ivan-gluscic101/STM32-ESP32-Microphone-Array-Sound-Localization/Sound Localization/Core/Src/main.c

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
/* Includes ------------------------------------------------------------------*/
#include "main.h"
#include "cmsis_os.h"

/* USER CODE BEGIN Includes */
#include "adc_driver.h"      /* Custom_ACQ_Start */
#include "task_manager.h"    /* app_tasks_init */
#include "app_init.h"        /* app_init (I2C + IMU + dijagnostika) */
/* USER CODE END Includes */


COM_InitTypeDef BspCOMInit;

/* USER CODE BEGIN PV */
/* RTOS taskovi i queue-ovi kreiraju se u task_manager.c (app_tasks_init).
 * I2C se inicijalizira LL driverom (i2c_driver.c), ne HAL handle-om. */
/* USER CODE END PV */

void SystemClock_Config(void);
static void MX_GPIO_Init(void);
static void MX_DMA_Init(void);
static void MX_ADC1_Init(void);
static void MX_UART4_Init(void);
static void MX_TIM8_Init(void);

/* USER CODE BEGIN PFP */
/* I2C1 inicijalizira LL driver (Custom_I2C1_Init iz i2c_driver.c), ne CubeMX —
 * zato ovdje nema MX_I2C1_Init. Taskovi (Start*Task) su u task_manager.c. */

/* USER CODE END PFP */

/**
  * @brief  The application entry point.
  * @retval int
  */
int main(void)
{

  /* MCU Configuration--------------------------------------------------------*/

  /* Reset of all peripherals, Initializes the Flash interface and the Systick. */
  HAL_Init();

  /* Configure the system clock */
  SystemClock_Config();

  /* Initialize all configured peripherals */
  MX_GPIO_Init();
  MX_DMA_Init();
  MX_ADC1_Init();
  MX_UART4_Init();
  MX_TIM8_Init();
  /* USER CODE BEGIN 2 */
  /* Aplikacijski init (I2C LL + IMU + dijagnostika + kalibracija žira). Lokalizacija
   * (time-domain, LOC_INIT) i RTOS objekti su u task_manageru (app_tasks_init). */
  app_init();
  /* USER CODE END 2 */

  /* USER CODE BEGIN RTOS_MUTEX */
  /* add mutexes, ... */
  /* USER CODE END RTOS_MUTEX */

  /* USER CODE BEGIN RTOS_SEMAPHORES */
  /* add semaphores, ... */
  /* USER CODE END RTOS_SEMAPHORES */

  /* USER CODE BEGIN RTOS_TIMERS */
  /* start timers, add new ones, ... */
  /* USER CODE END RTOS_TIMERS */

  /* USER CODE BEGIN RTOS_THREADS */
  /* Svi queue-ovi i taskovi (ACQ/LOC/UART/IMU) kreiraju se u task_manager.c.
   * Kreiraj RTOS objekte (queueDmaEventHandle i dr.) PRIJE pokretanja ADC/DMA/TIM:
   * DMA1_Channel1_IRQHandler šalje u queueDmaEventHandle, koji nastaje ovdje.
   * Da ISR ne gađa NULL handle, Custom_ACQ_Start() ide tek nakon ovoga. */
  app_tasks_init();
  Custom_ACQ_Start();
  /* USER CODE END RTOS_THREADS */

  /* Initialize led */
  BSP_LED_Init(LED_GREEN);

  /* Initialize USER push-button, will be used to trigger an interrupt each time it's pressed.*/
  BSP_PB_Init(BUTTON_USER, BUTTON_MODE_EXTI);

  /* Initialize COM1 port (115200, 8 bits (7-bit data + 1 stop bit), no parity */
  BspCOMInit.BaudRate   = 115200;
  BspCOMInit.WordLength = COM_WORDLENGTH_8B;
  BspCOMInit.StopBits   = COM_STOPBITS_1;
  BspCOMInit.Parity     = COM_PARITY_NONE;
  BspCOMInit.HwFlowCtl  = COM_HWCONTROL_NONE;
  if (BSP_COM_Init(COM1, &BspCOMInit) != BSP_ERROR_NONE)
  {
    Error_Handler();
  }

  /* Start scheduler */
  osKernelStart();

  /* We should never get here as control is now taken by the scheduler */

  /* Infinite loop */
  /* USER CODE BEGIN WHILE */
  while (1)
  {

    /* USER CODE END WHILE */

    /* USER CODE BEGIN 3 */
  }
  /* USER CODE END 3 */
}

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
/* USER CODE BEGIN 4 */
/* HAL_TIM_PeriodElapsedCallback (TIM6 → HAL_IncTick) generira CubeMX niže. */

void vApplicationStackOverflowHook(TaskHandle_t xTask, char *pcTaskName)
{
  (void)xTask; (void)pcTaskName;
  __disable_irq();
  while (1) {}
}

void vApplicationMallocFailedHook(void)
{
  __disable_irq();
  while (1) {}
}
/* USER CODE END 4 */

/* Taskovi (StartACQTask / StartLOCTask / StartUARTTask / StartIMUTask) i njihove
 * implementacije su u task_manager.c. defaultTask se ne koristi. */

/**
  * @brief  Period elapsed callback in non blocking mode
  * @note   This function is called  when TIM6 interrupt took place, inside
  * HAL_TIM_IRQHandler(). It makes a direct call to HAL_IncTick() to increment
  * a global variable "uwTick" used as application time base.
  * @param  htim : TIM handle
  * @retval None
  */
void HAL_TIM_PeriodElapsedCallback(TIM_HandleTypeDef *htim)
{
  if (htim->Instance == TIM6)
  {
    HAL_IncTick();
  }
}

/**
  * @brief  This function is executed in case of error occurrence.
  * @retval None
  */
void Error_Handler(void)
{
  /* USER CODE BEGIN Error_Handler_Debug */
  /* User can add his own implementation to report the HAL error return state */
  __disable_irq();
  while (1)
  {
  }
  /* USER CODE END Error_Handler_Debug */
}
#ifdef USE_FULL_ASSERT
/**
  * @brief  Reports the name of the source file and the source line number
  *         where the assert_param error has occurred.
  * @param  file: pointer to the source file name
  * @param  line: assert_param error line source number
  * @retval None
  */
void assert_failed(uint8_t *file, uint32_t line)
{
  /* USER CODE BEGIN 6 */
  /* User can add his own implementation to report the file name and line number,
     ex: printf("Wrong parameters value: file %s on line %d\r\n", file, line) */
  /* USER CODE END 6 */
}
#endif /* USE_FULL_ASSERT */
