ivan-gluscic101/STM32-ESP32-Microphone-Array-Sound-Localization/Sound Localization/Core/CustomDriverSet/SrcDriver/adc_driver.c

#include "adc_driver.h"

uint16_t adc_buffer[FULL_BUFFER];

void Custom_ADC_Init(void)
{
    LL_ADC_InitTypeDef       ADC_InitStruct       = {0};
    LL_ADC_REG_InitTypeDef   ADC_REG_InitStruct   = {0};
    LL_ADC_CommonInitTypeDef ADC_CommonInitStruct = {0};
    LL_GPIO_InitTypeDef      GPIO_InitStruct      = {0};

    LL_RCC_SetADCClockSource(LL_RCC_ADC12_CLKSOURCE_SYSCLK);
    LL_AHB2_GRP1_EnableClock(LL_AHB2_GRP1_PERIPH_ADC12);

    /* Analogni pinovi — GPIO clocks su već uključeni u Custom_GPIO_Init */
    GPIO_InitStruct.Mode = LL_GPIO_MODE_ANALOG;
    GPIO_InitStruct.Pull = LL_GPIO_PULL_NO;

    GPIO_InitStruct.Pin = LL_GPIO_PIN_14;  /* PB14 → ADC1_IN5 */
    LL_GPIO_Init(GPIOB, &GPIO_InitStruct);

    GPIO_InitStruct.Pin = LL_GPIO_PIN_0;   /* PC0  → ADC1_IN6 */
    LL_GPIO_Init(GPIOC, &GPIO_InitStruct);

    GPIO_InitStruct.Pin = LL_GPIO_PIN_1;   /* PC1  → ADC1_IN7 */
    LL_GPIO_Init(GPIOC, &GPIO_InitStruct);

    GPIO_InitStruct.Pin = LL_GPIO_PIN_2;   /* PC2  → ADC1_IN8 */
    LL_GPIO_Init(GPIOC, &GPIO_InitStruct);

    /* DMA kanal za ADC1 — clock i NVIC su postavljeni u Custom_DMA_Init */
    LL_DMA_SetPeriphRequest(DMA1, LL_DMA_CHANNEL_1, LL_DMAMUX_REQ_ADC1);
    LL_DMA_SetDataTransferDirection(DMA1, LL_DMA_CHANNEL_1, LL_DMA_DIRECTION_PERIPH_TO_MEMORY);
    LL_DMA_SetChannelPriorityLevel(DMA1, LL_DMA_CHANNEL_1, LL_DMA_PRIORITY_HIGH);
    LL_DMA_SetMode(DMA1, LL_DMA_CHANNEL_1, LL_DMA_MODE_CIRCULAR);
    LL_DMA_SetPeriphIncMode(DMA1, LL_DMA_CHANNEL_1, LL_DMA_PERIPH_NOINCREMENT);
    LL_DMA_SetMemoryIncMode(DMA1, LL_DMA_CHANNEL_1, LL_DMA_MEMORY_INCREMENT);
    LL_DMA_SetPeriphSize(DMA1, LL_DMA_CHANNEL_1, LL_DMA_PDATAALIGN_HALFWORD);
    LL_DMA_SetMemorySize(DMA1, LL_DMA_CHANNEL_1, LL_DMA_MDATAALIGN_HALFWORD);

    /* ADC inicijalizacija */
    ADC_InitStruct.Resolution  = LL_ADC_RESOLUTION_12B;
    ADC_InitStruct.DataAlignment = LL_ADC_DATA_ALIGN_RIGHT;
    ADC_InitStruct.LowPowerMode  = LL_ADC_LP_MODE_NONE;
    LL_ADC_Init(ADC1, &ADC_InitStruct);

    ADC_REG_InitStruct.TriggerSource    = LL_ADC_REG_TRIG_EXT_TIM8_TRGO;
    ADC_REG_InitStruct.SequencerLength  = LL_ADC_REG_SEQ_SCAN_ENABLE_4RANKS;
    ADC_REG_InitStruct.SequencerDiscont = LL_ADC_REG_SEQ_DISCONT_DISABLE;
    ADC_REG_InitStruct.ContinuousMode   = LL_ADC_REG_CONV_SINGLE;
    ADC_REG_InitStruct.DMATransfer      = LL_ADC_REG_DMA_TRANSFER_UNLIMITED;
    ADC_REG_InitStruct.Overrun          = LL_ADC_REG_OVR_DATA_PRESERVED;
    LL_ADC_REG_Init(ADC1, &ADC_REG_InitStruct);

    LL_ADC_SetGainCompensation(ADC1, 0);
    LL_ADC_SetOverSamplingScope(ADC1, LL_ADC_OVS_DISABLE);

    ADC_CommonInitStruct.CommonClock = LL_ADC_CLOCK_SYNC_PCLK_DIV4;
    ADC_CommonInitStruct.Multimode   = LL_ADC_MULTI_INDEPENDENT;
    LL_ADC_CommonInit(__LL_ADC_COMMON_INSTANCE(ADC1), &ADC_CommonInitStruct);

    LL_ADC_REG_SetTriggerEdge(ADC1, LL_ADC_REG_TRIG_EXT_RISING);
    LL_ADC_DisableDeepPowerDown(ADC1);
    LL_ADC_EnableInternalRegulator(ADC1);

    uint32_t wait = ((LL_ADC_DELAY_INTERNAL_REGUL_STAB_US * (SystemCoreClock / (100000 * 2))) / 10);
    while (wait-- != 0);

    /* Sekvencer — 4 kanala: PB14(IN5), PC0(IN6), PC1(IN7), PC2(IN8) */
    LL_ADC_REG_SetSequencerRanks(ADC1, LL_ADC_REG_RANK_1, LL_ADC_CHANNEL_5);
    LL_ADC_SetChannelSamplingTime(ADC1, LL_ADC_CHANNEL_5, LL_ADC_SAMPLINGTIME_24CYCLES_5);
    LL_ADC_SetChannelSingleDiff(ADC1, LL_ADC_CHANNEL_5, LL_ADC_SINGLE_ENDED);

    LL_ADC_REG_SetSequencerRanks(ADC1, LL_ADC_REG_RANK_2, LL_ADC_CHANNEL_6);
    LL_ADC_SetChannelSamplingTime(ADC1, LL_ADC_CHANNEL_6, LL_ADC_SAMPLINGTIME_24CYCLES_5);
    LL_ADC_SetChannelSingleDiff(ADC1, LL_ADC_CHANNEL_6, LL_ADC_SINGLE_ENDED);

    LL_ADC_REG_SetSequencerRanks(ADC1, LL_ADC_REG_RANK_3, LL_ADC_CHANNEL_7);
    LL_ADC_SetChannelSamplingTime(ADC1, LL_ADC_CHANNEL_7, LL_ADC_SAMPLINGTIME_24CYCLES_5);
    LL_ADC_SetChannelSingleDiff(ADC1, LL_ADC_CHANNEL_7, LL_ADC_SINGLE_ENDED);

    LL_ADC_REG_SetSequencerRanks(ADC1, LL_ADC_REG_RANK_4, LL_ADC_CHANNEL_8);
    LL_ADC_SetChannelSamplingTime(ADC1, LL_ADC_CHANNEL_8, LL_ADC_SAMPLINGTIME_24CYCLES_5);
    LL_ADC_SetChannelSingleDiff(ADC1, LL_ADC_CHANNEL_8, LL_ADC_SINGLE_ENDED);
}

void Custom_ACQ_Start(void)
{
    LL_ADC_StartCalibration(ADC1, LL_ADC_SINGLE_ENDED);
    while (LL_ADC_IsCalibrationOnGoing(ADC1) != 0);

    LL_ADC_Enable(ADC1);
    while (LL_ADC_IsActiveFlag_ADRDY(ADC1) == 0);

    LL_DMA_SetMemoryAddress(DMA1, LL_DMA_CHANNEL_1, (uint32_t)adc_buffer);
    LL_DMA_SetPeriphAddress(DMA1, LL_DMA_CHANNEL_1,
        LL_ADC_DMA_GetRegAddr(ADC1, LL_ADC_DMA_REG_REGULAR_DATA));
    LL_DMA_SetDataLength(DMA1, LL_DMA_CHANNEL_1, FULL_BUFFER);

    LL_DMA_EnableIT_HT(DMA1, LL_DMA_CHANNEL_1);
    LL_DMA_EnableIT_TC(DMA1, LL_DMA_CHANNEL_1);
    LL_DMA_EnableChannel(DMA1, LL_DMA_CHANNEL_1);

    LL_ADC_REG_StartConversion(ADC1);
    LL_TIM_EnableCounter(TIM8);
}
