ivan-gluscic101/STM32-ESP32-Microphone-Array-Sound-Localization/Sound Localization/Core/CustomDriverSet/IncDriver/uart_driver.h

#ifndef UART_DRIVER_H
#define UART_DRIVER_H

#include "main.h"
#include <stdint.h>

void Custom_UART4_Init(void);
void UART_SendAnglePacket(int16_t phi_tenth_deg, uint8_t strength);

/*
 * UART_SendAngle3DPacket — šalje 3D lokalizacijski paket (tip 0x03, 10 bajta)
 *
 * Format: [0xAA][0xBB][0x03][AZ_H][AZ_L][EL_H][EL_L][STR][0xCC][0xDD]
 *   AZ = azimut u 0.1°, big-endian int16  (0..3600, tj. 0°..360°)
 *   EL = elevacija u 0.1°, big-endian int16 (-900..+900, tj. ±90°)
 *   STR = jakost 0-100
 */
void UART_SendAngle3DPacket(int16_t az_tenth, int16_t el_tenth, uint8_t strength);

/*
 * UART_SendOrientationPacket — šalje orijentaciju plohe (IMU) na ESP32.
 * Tip 0x05 (različit od 0x03 lokalizacije!) → ESP32 raspoznaje izvor podataka.
 *
 * Format: [0xAA][0xBB][0x05][RL_H][RL_L][PT_H][PT_L][YW_H][YW_L][FLAGS][0xCC][0xDD]
 *   RL = roll u 0.1°, big-endian int16  (-1800..+1800)
 *   PT = pitch u 0.1°, big-endian int16 (-900..+900)
 *   YW = yaw u 0.1°, big-endian int16   (0..3600; bez magnetometra: relativan/drift)
 *   FLAGS bit0 = magnetometar valjan (1) / yaw samo iz žira (0)
 */
void UART_SendOrientationPacket(int16_t roll_tenth, int16_t pitch_tenth,
                                int16_t yaw_tenth, uint8_t flags);

/*
 * UART_SendRawCapture — pošalji sirove (deinterleaveane, poravnate) uzorke sva
 * 4 kanala na ESP32 kao binarni okvir (tip 0x04), nakon detekcije. Blocking.
 *
 * Okvir:
 *   [0xAA][0xBB][0x04][NCH][N_H][N_L]  zaglavlje
 *     NCH = broj kanala (NUM_CH),  N = uzoraka po kanalu (SAMPLES_PER_CHANNEL),
 *     big-endian
 *   zatim NCH × N uzoraka, big-endian uint16, kanal-major redoslijed:
 *     ch0[0..N-1], ch1[0..N-1], ch2[0..N-1], ch3[0..N-1]
 *   [0xCC][0xDD]  završetak
 *
 * Svaki niz mora imati SAMPLES_PER_CHANNEL uint16 uzoraka.
 */
void UART_SendRawCapture(const uint16_t *ch0, const uint16_t *ch1,
                         const uint16_t *ch2, const uint16_t *ch3);

/*
 * UART_SendString — pošalji nulu-terminiran string na UART (blocking).
 */
void UART_SendString(const char *str);

/*
 * UART_SendRawCaptureCSV — ispiši sirove uzorke sva 4 kanala kao ČITLJIV CSV
 * tekst (blocking). Format se vidi direktno na ESP32 idf.py monitoru:
 *
 *   RAW START N=1024
 *   idx,M1,M2,M3,M4
 *   0,2047,2050,2041,2048
 *   1,...
 *   RAW END
 *
 * Svaki niz mora imati SAMPLES_PER_CHANNEL uzoraka. Šalje SAMPLES_PER_CHANNEL
 * redaka — na 115200 baud to traje ~2 s, pa zovi samo pri detekciji.
 */
void UART_SendRawCaptureCSV(const uint16_t *ch0, const uint16_t *ch1,
                            const uint16_t *ch2, const uint16_t *ch3);

#endif /* UART_DRIVER_H */
