ivan-gluscic101/STM32-ESP32-Microphone-Array-Sound-Localization/ESP32_Visualization/components/Inc/web_server.h

#ifndef WEB_SERVER_H
#define WEB_SERVER_H

#include <stdint.h>

/**
 * @brief Pokreće HTTP server i WebSocket endpoint.
 */
void web_server_init(void);

/**
 * @brief Šalje podatke o kutu svim spojenim WebSocket klijentima.
 *        Koordinatni sustav je isti kao u glavnom projektu (Sound Localization):
 *        azimuth — kut u XY ravnini [0°, 360°), 0° = +X naprijed, 90° = +Y lijevo,
 *                  180° = nazad, 270° = desno.
 *        polar   — elevacija [-90°, +90°], +90° = ravno gore (+Z), 0 = horizont.
 *                  (Naziv parametra je povijesni; vrijednost je elevacija.)
 */
void web_server_send_data(float azimuth, float polar, uint8_t strength);

/**
 * @brief Šalje orijentaciju plohe mikrofona (IMU) svim WebSocket klijentima.
 *        Vizualizacija rotira ravnine/mikrofone prema ovim kutevima, pa
 *        prikazani smjer zvuka biva u globalnom (svjetskom) okviru iako STM32
 *        šalje smjer u lokalnom okviru ploče.
 *
 *        roll  — rotacija oko X osi (stupnjevi, -180..+180)
 *        pitch — rotacija oko Y osi (stupnjevi, -90..+90)
 *
 *        Yaw se ne koristi (vizualizacija zakreće plohu samo po roll/pitch
 *        iz gravitacije), pa nije ni parametar.
 */
void web_server_send_orientation(float roll, float pitch);

#endif
