ivan-gluscic101/STM32-ESP32-Microphone-Array-Sound-Localization/Sound Localization/Core/CustomDriverSet/SrcDriver/app_init.c

#include "app_init.h"

#include "i2c_driver.h"
#include "mpu9250.h"
#include "uart_driver.h"

#include <stdio.h>

void app_init(void)
{
    /* IMU: I2C1 (PB8/PB9) + MPU-9250. Ako modul nije spojen, MPU_Init vraća
     * UNKNOWN i IMU_Task će mirno mirovati — ostatak sustava radi normalno.
     * Kalibracija žira traži da ploča bude NEPOMIČNA tijekom starta. */
    Custom_I2C1_Init();
    mpu_chip_t imu_chip = MPU_Init();

    /* Dijagnostički ispis na UART (vidi se na ESP32 idf.py monitoru kao tekst).
     * WHO_AM_I: 0x70=6500(bez kompasa), 0x71=9250, 0x73=9255, 0x68=stari 6050.
     * Privremeno za identifikaciju čipa — slobodno ukloni kasnije. */
    {
        char line[64];
        const char *name = (imu_chip == MPU_CHIP_9250) ? "MPU-9250" :
                           (imu_chip == MPU_CHIP_9255) ? "MPU-9255" :
                           (imu_chip == MPU_CHIP_6500) ? "MPU-6500" : "UNKNOWN";
        snprintf(line, sizeof(line),
                 "IMU: %s  WHOAMI=0x%02X  ADDR=0x%02X  MAG=%d\r\n",
                 name, MPU_WhoAmI(), MPU_Address(), MPU_HasMag());
        UART_SendString(line);
    }

    if (imu_chip != MPU_CHIP_UNKNOWN) {
        MPU_CalibrateGyro();
    }
}
