ivan-gluscic101/STM32-ESP32-Microphone-Array-Sound-Localization/ESP32_Visualization/components/Src/wifi_manager.c

#include "wifi_manager.h"
#include "esp_wifi.h"
#include "esp_event.h"
#include "esp_log.h"
#include "nvs_flash.h"
#include <string.h>

#define AP_SSID     "SoundLocalization"
#define AP_PASS     "soundloc123"
#define AP_CHANNEL  1
#define AP_MAX_CONN 4

static const char *TAG = "WIFI_MANAGER";

void wifi_manager_init(void) {
    ESP_ERROR_CHECK(esp_netif_init());
    ESP_ERROR_CHECK(esp_event_loop_create_default());
    esp_netif_create_default_wifi_ap();

    wifi_init_config_t cfg = WIFI_INIT_CONFIG_DEFAULT();
    ESP_ERROR_CHECK(esp_wifi_init(&cfg));

    wifi_config_t wifi_config = {
        .ap = {
            .ssid = AP_SSID,
            .ssid_len = strlen(AP_SSID),
            .channel = AP_CHANNEL,
            .password = AP_PASS,
            .max_connection = AP_MAX_CONN,
            .authmode = WIFI_AUTH_WPA2_PSK,
        },
    };

    ESP_ERROR_CHECK(esp_wifi_set_mode(WIFI_MODE_AP));
    ESP_ERROR_CHECK(esp_wifi_set_config(WIFI_IF_AP, &wifi_config));
    ESP_ERROR_CHECK(esp_wifi_start());

    ESP_LOGI(TAG, "AP pokrennut. SSID: %s, IP: 192.168.4.1", AP_SSID);
}
