ivan-gluscic101/STM32-ESP32-Microphone-Array-Sound-Localization/ESP32_Visualization/components/Inc/sound_loc_processor.h

#ifndef SOUND_LOC_PROCESSOR_H
#define SOUND_LOC_PROCESSOR_H

/**
 * @brief Inicijalizira procesor lokalizacije zvuka.
 *        Pokreće FreeRTOS task koji sluša UART i parsira pakete kuta.
 */
void sound_loc_processor_init(void);

#endif // SOUND_LOC_PROCESSOR_H
