ivan-gluscic101/STM32-ESP32-Microphone-Array-Sound-Localization/(commit log)

2026-05-04 Dodan početak za esp32 lokalizaciju
2026-05-09 Web based 2d-180 degree localization sort of works, next is the 3d localization part on the stm32
2026-05-10 Mock signals displayed in 3d on esp32 side work, however something is wrong etiher with the loclaization or the uart on stm32/esp32 side?
    [adc_driver.c, audio_common.h, dma_driver.c, gpio_driver.c, main.c, sound_loc_processor.c, task_manager.c, task_manager.h]
2026-05-11 Deleted sma_filter, deleted ema_filter and delted the python visualization app. Cuurrent main has only one task active to see wheter or not thecommunication between the two microcontrollers work and 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
    [Sound Localization Debug.cfg]
2026-05-11 There exist some localization from stm32 to esp32. The viualization works, however the localization part is at best accurate to the correct octant. Maybe the next step should be implementing a timing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
    [main.c, task_manager.c, task_manager.h, web_server.c]
2026-05-20 The localization is touchy - many wrong readings
    [main.c, task_manager.h]
2026-05-21 Added few edge chase fixes
    [main.c, sound_loc_processor.c, uart_driver.c, uart_driver.h]
2026-06-08 Added UART printout for clap detection
2026-06-19 Added 3d localization, with z >= 3 assumption due to one microphone not working
    [audio_common.h, main.c, microphone_config.h, task_manager.c, web_server.c, web_server.h]
