ivan-gluscic101/STM32-ESP32-Microphone-Array-Sound-Localization/(notices)

Notices in the files:
Core/Inc/main.h:
Copyright (c) 2026 STMicroelectronics.
All rights reserved.
This software is licensed under terms that can be found in the LICENSE file
